Mamorup/apple-iigs-ui12-ui14-rp2350/docs/validation/key_led_verify_2026-10-27.txt

> SELFTEST
SELFTEST failures=0

> RESET
SYSTEM RESET pulse 4ms

> LED
KEY_LED=0 any_key_down=0

> KEY 37
KEY queued

> LED
KEY_LED=1 any_key_down=1

> KEY b7
KEY queued

> LED
KEY_LED=0 any_key_down=0

> STATUS
STATUS armed=1 ready=1 cycles=19118 reads=19054 writes=64 overflow=0 reset=1 glu=80 sync=1 cmd=06 need=0 got=3 rom_reads=0 poll=1 chip_revision=3

> INPUT
INPUT events=2 packets=0 published=0 mods=20 held=0 pending=0 last_ascii=00 notify=00 desk=0 recent= 37 b7

GLU key=00 mods=20 irq_enable=02 system_status=90

> PINS
PINS RESET=1 IRQ_GATE=0 RESET_GATE=0 COMMAND=0 OPTION=0 raw=00423ea0 reset_pulses=1
