Mamorup/apple-iigs-ui12-ui14-rp2350/hardware/schematic.pdf

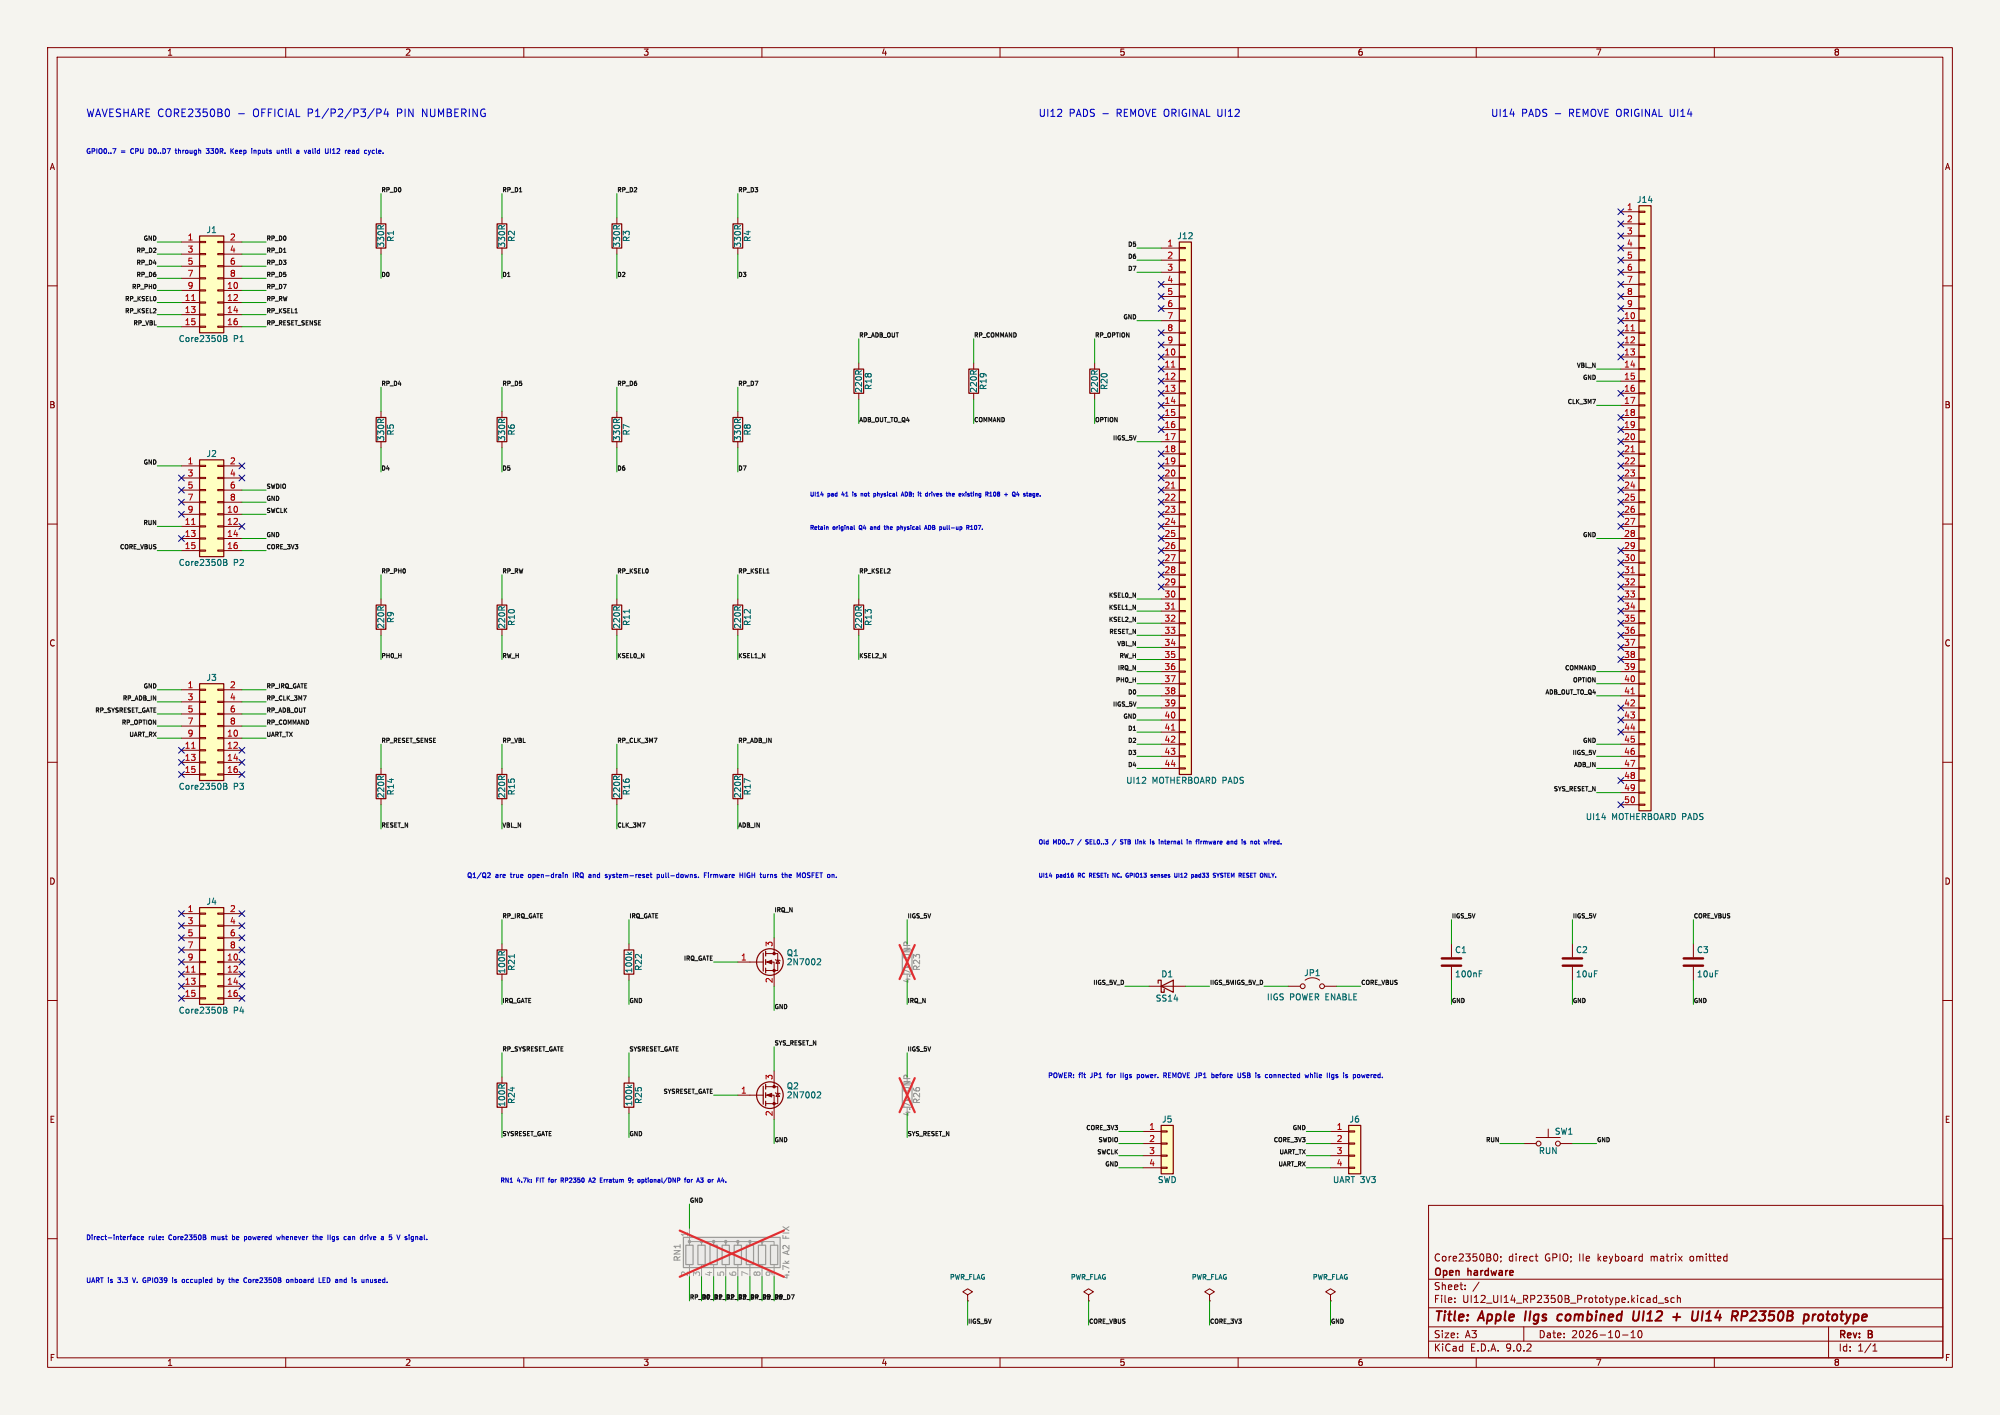
[picture p1: page 1]

UI14 pad16 RC RESET: NC. GPIO13 senses UI12 pad33 SYSTEM RESET ONLY.

Id: 1/1 Title: Apple IIgs combined UI12 + UI14 RP2350B prototype
