Mamorup/apple-iigs-ui12-ui14-rp2350/hardware/kicad/UI12_UI14_RP2350B_Prototype.kicad_sch

## KiCad design hardware/kicad/UI12_UI14_RP2350B_Prototype.kicad_sch (2026-10-28)

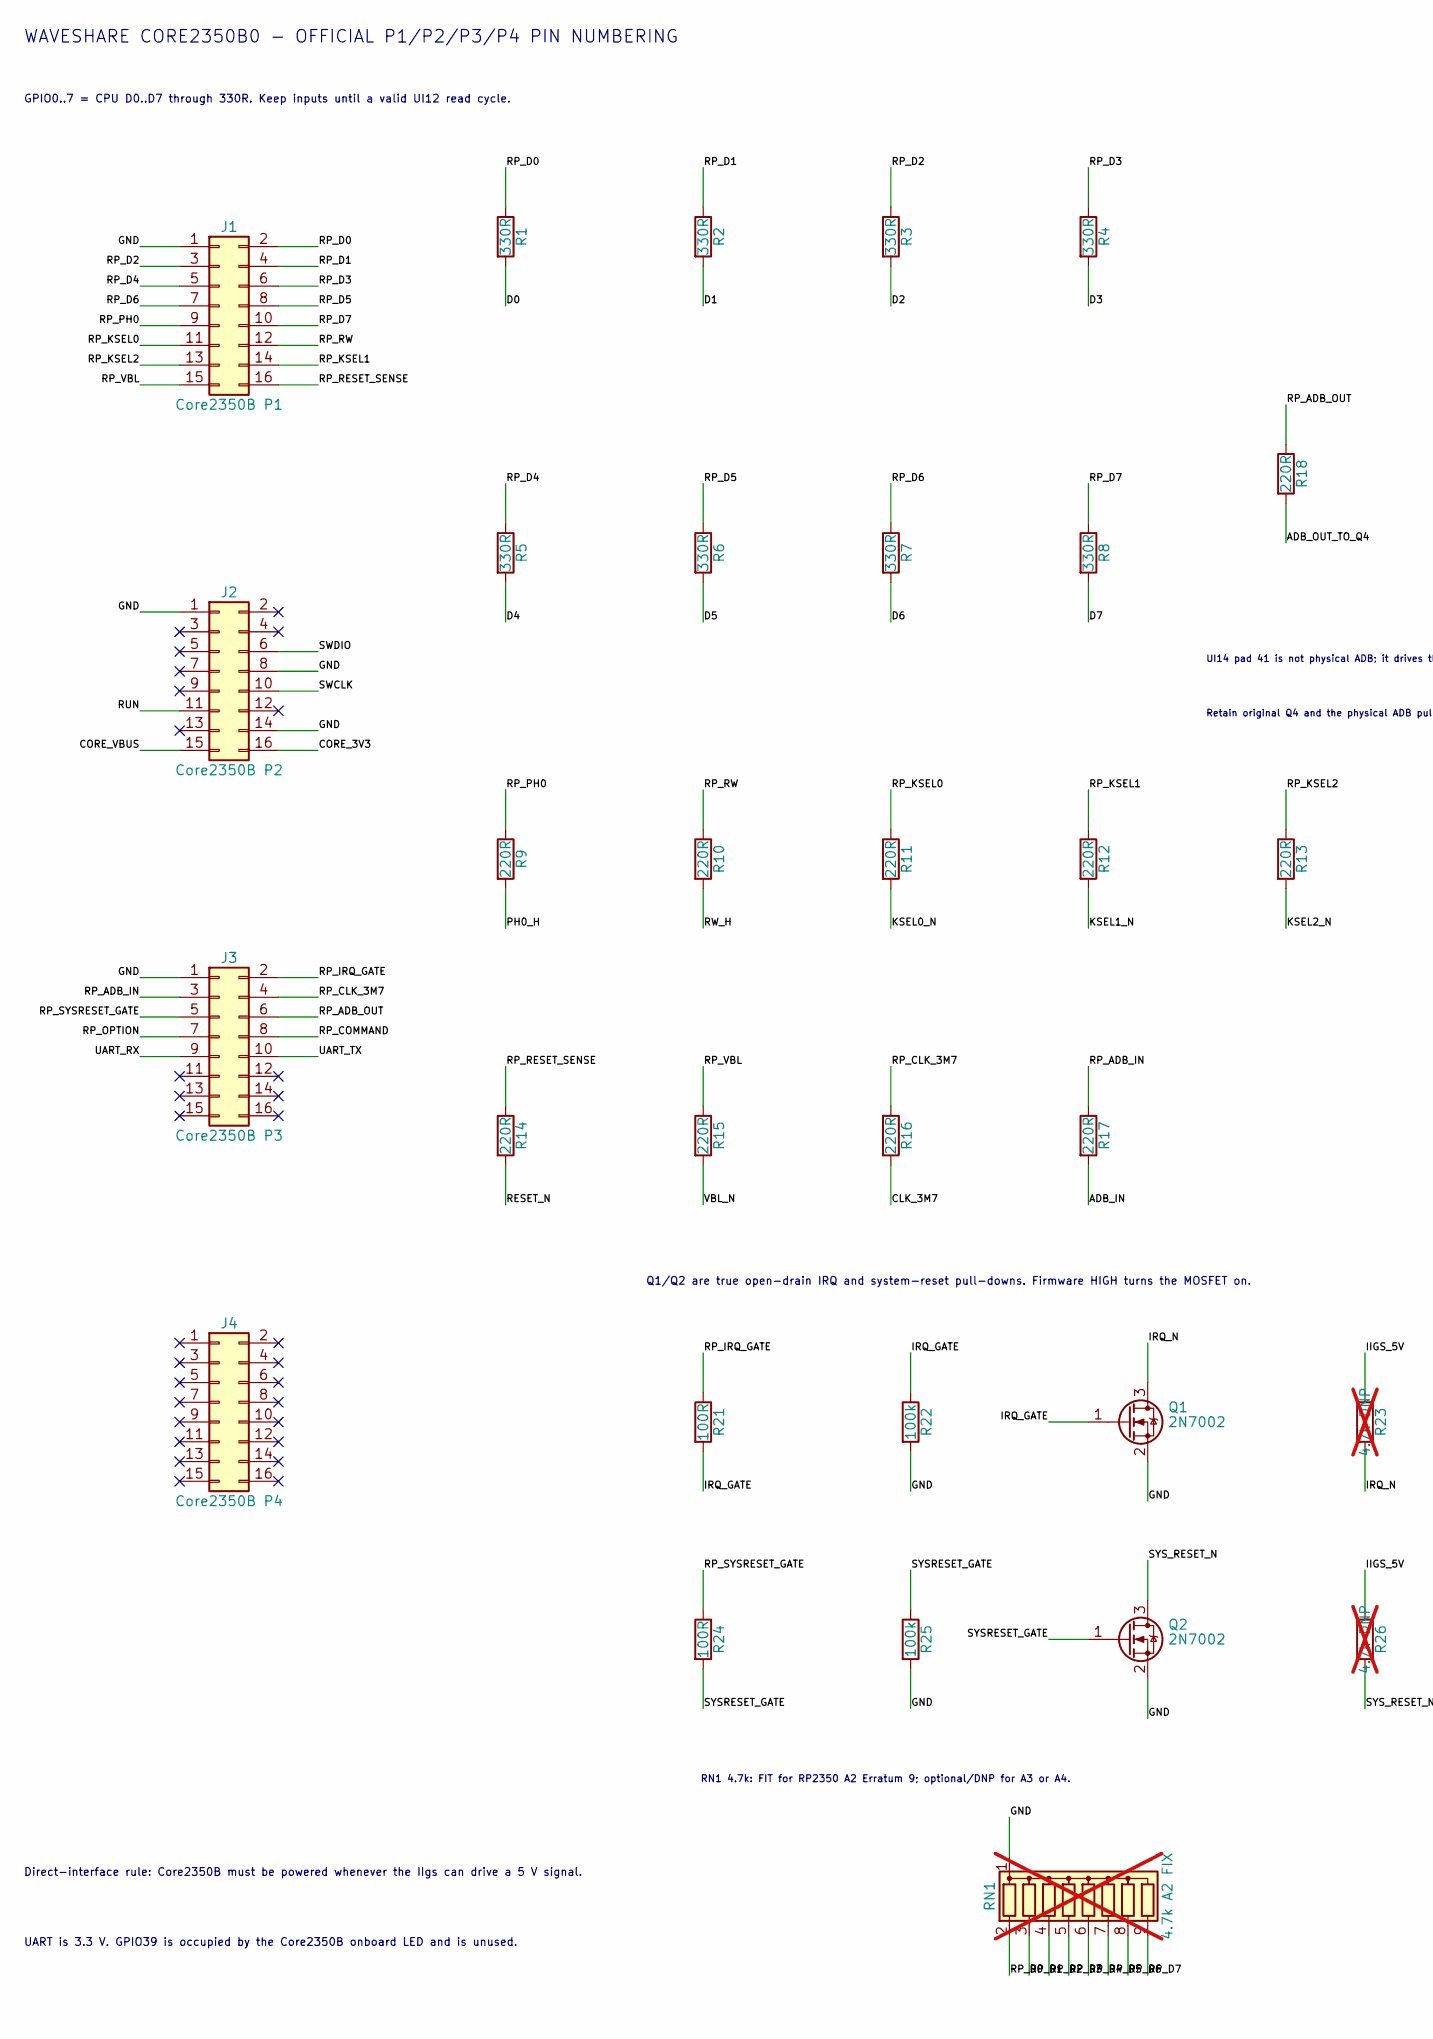
[picture p2: schematic UI12_UI14_RP2350B_Prototype.kicad_sch, part in row 1, column 1]

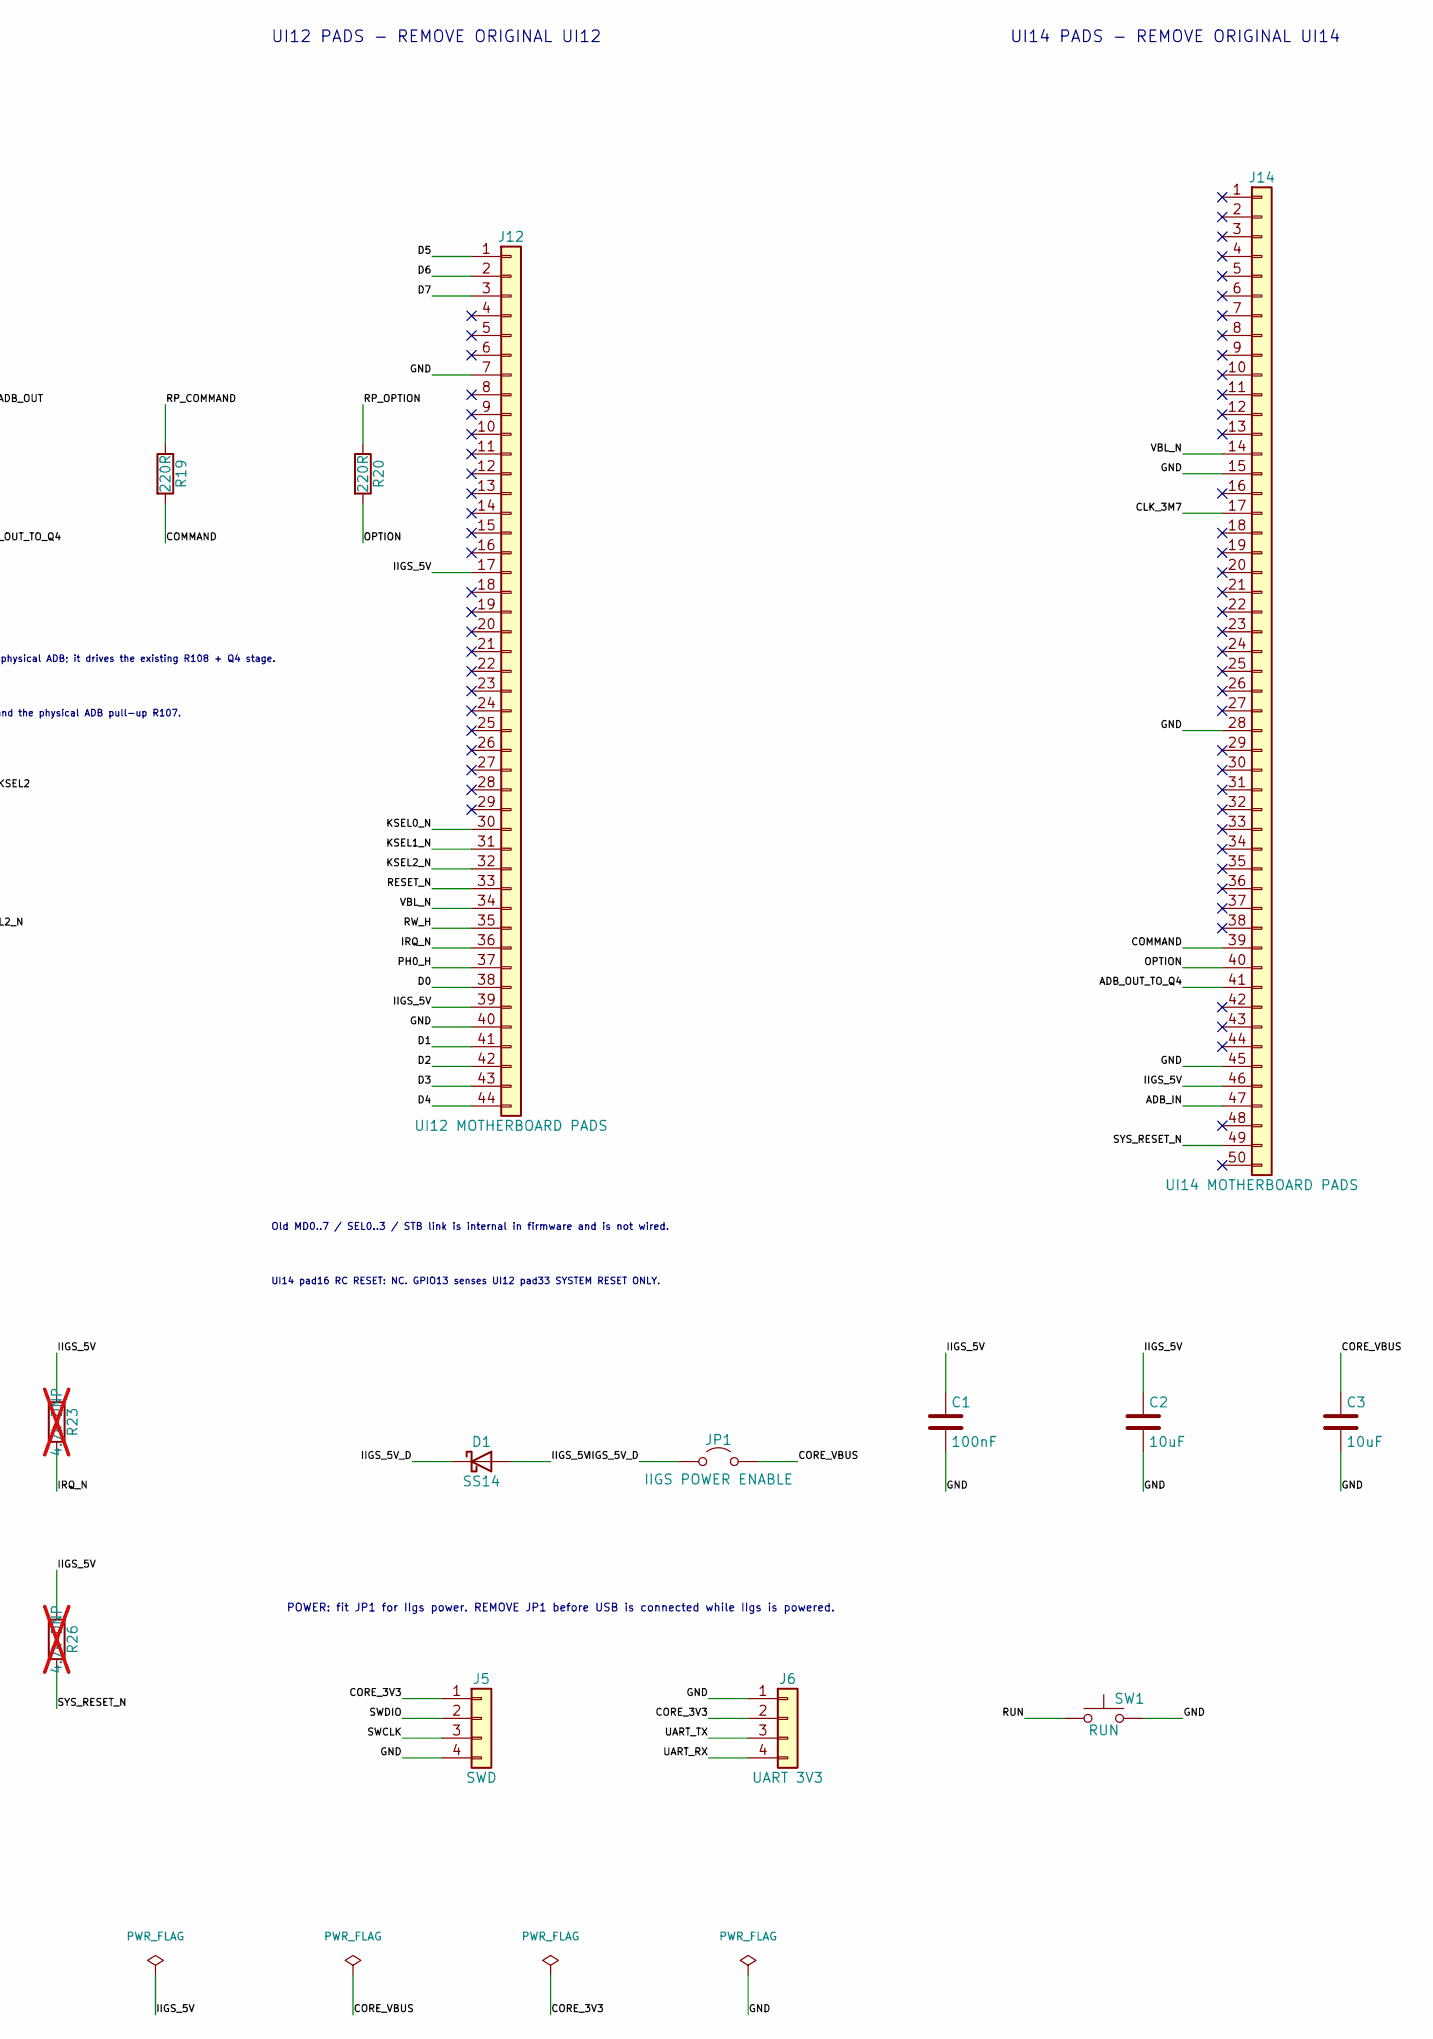
[picture p3: schematic UI12_UI14_RP2350B_Prototype.kicad_sch, part in row 1, column 2]

Parts:
C1: 100nF; C_0805_2012Metric
C2, C3: 10uF; C_1206_3216Metric
D1: SS14; D_SMA; MPN SS14
J1: Core2350B P1; PinSocket_2x08_P2.54mm_Vertical
J2: Core2350B P2; PinSocket_2x08_P2.54mm_Vertical
J3: Core2350B P3; PinSocket_2x08_P2.54mm_Vertical
J4: Core2350B P4; PinSocket_2x08_P2.54mm_Vertical
J5: SWD; PinHeader_1x04_P2.54mm_Vertical
J6: UART 3V3; PinHeader_1x04_P2.54mm_Vertical
J12: UI12 MOTHERBOARD PADS
J14: UI14 MOTHERBOARD PADS
JP1: IIGS POWER ENABLE; PinHeader_1x02_P2.54mm_Vertical
Q1, Q2: 2N7002; SOT-23; MPN 2N7002
R1, R2, R3, R4, R5, R6, R7, R8: 330R; R_0805_2012Metric; MPN RC0805FR-07330RL
R9, R10, R11, R12, R13, R14, R15, R16, R17, R18, R19, R20: 220R; R_0805_2012Metric; MPN RC0805FR-07220RL
R21, R24: 100R; R_0805_2012Metric
R22, R25: 100k; R_0805_2012Metric
R23, R26: 4.7k DNP; R_0805_2012Metric; not fitted
RN1: 4.7k A2 FIX; R_Array_SIP9; not fitted
SW1: RUN; SW_PUSH_6mm

Connections:
ADB_IN: J14.47, R17.2
ADB_OUT_TO_Q4: J14.41, R18.2
CLK_3M7: J14.17, R16.2
COMMAND: J14.39, R19.2
CORE_3V3: J2.16, J5.1, J6.2
CORE_VBUS: C3.1, J2.15, JP1.2 (B)
D0: J12.38, R1.2
D1: J12.41, R2.2
D2: J12.42, R3.2
D3: J12.43, R4.2
D4: J12.44, R5.2
D5: J12.1, R6.2
D6: J12.2, R7.2
D7: J12.3, R8.2
GND: C1.2, C2.2, C3.2, J1.1, J2.1, J2.8, J2.14, J3.1, J5.4, J6.1, J12.7, J12.40, J14.15, J14.28, J14.45, Q1.2 (S), Q2.2 (S), R22.2, R25.2, RN1.1 (common), SW1.2
IIGS_5V: C1.1, C2.1, D1.2 (A), J12.17, J12.39, J14.46, R23.1, R26.1
IIGS_5V_D: D1.1 (K), JP1.1 (A)
IRQ_GATE: Q1.1 (G), R21.2, R22.1
IRQ_N: J12.36, Q1.3 (D), R23.2
KSEL0_N: J12.30, R11.2
KSEL1_N: J12.31, R12.2
KSEL2_N: J12.32, R13.2
OPTION: J14.40, R20.2
PH0_H: J12.37, R9.2
RESET_N: J12.33, R14.2
RP_ADB_IN: J3.3, R17.1
RP_ADB_OUT: J3.6, R18.1
RP_CLK_3M7: J3.4, R16.1
RP_COMMAND: J3.8, R19.1
RP_D0: J1.2, R1.1, RN1.2 (R1)
RP_D1: J1.4, R2.1, RN1.3 (R2)
RP_D2: J1.3, R3.1, RN1.4 (R3)
RP_D3: J1.6, R4.1, RN1.5 (R4)
RP_D4: J1.5, R5.1, RN1.6 (R5)
RP_D5: J1.8, R6.1, RN1.7 (R6)
RP_D6: J1.7, R7.1, RN1.8 (R7)
RP_D7: J1.10, R8.1, RN1.9 (R8)
RP_IRQ_GATE: J3.2, R21.1
RP_KSEL0: J1.11, R11.1
RP_KSEL1: J1.14, R12.1
RP_KSEL2: J1.13, R13.1
RP_OPTION: J3.7, R20.1
RP_PH0: J1.9, R9.1
RP_RESET_SENSE: J1.16, R14.1
RP_RW: J1.12, R10.1
RP_SYSRESET_GATE: J3.5, R24.1
RP_VBL: J1.15, R15.1
RUN: J2.11, SW1.1
RW_H: J12.35, R10.2
SWCLK: J2.10, J5.3
SWDIO: J2.6, J5.2
SYSRESET_GATE: Q2.1 (G), R24.2, R25.1
SYS_RESET_N: J14.49, Q2.3 (D), R26.2
UART_RX: J3.9, J6.4
UART_TX: J3.10, J6.3
VBL_N: J12.34, J14.14, R15.2

Notes on the sheet:
WAVESHARE CORE2350B0 - OFFICIAL P1/P2/P3/P4 PIN NUMBERING
GPIO0..7 = CPU D0..D7 through 330R. Keep inputs until a valid UI12 read cycle.
UI12 PADS - REMOVE ORIGINAL UI12
UI14 PADS - REMOVE ORIGINAL UI14
Old MD0..7 / SEL0..3 / STB link is internal in firmware and is not wired.
UI14 pad16 RC RESET: NC. GPIO13 senses UI12 pad33 SYSTEM RESET ONLY.
UI14 pad 41 is not physical ADB; it drives the existing R108 + Q4 stage.
Retain original Q4 and the physical ADB pull-up R107.
Q1/Q2 are true open-drain IRQ and system-reset pull-downs. Firmware HIGH turns the MOSFET on.
POWER: fit JP1 for IIgs power. REMOVE JP1 before USB is connected while IIgs is powered.
Direct-interface rule: Core2350B must be powered whenever the IIgs can drive a 5 V signal.
UART is 3.3 V. GPIO39 is occupied by the Core2350B onboard LED and is unused.
RN1 4.7k: FIT for RP2350 A2 Erratum 9; optional/DNP for A3 or A4.
